defconfurs/dcfurs-badge-dc27/doc/mrswmy3pnzpwm5lsonpw65tbnr2gs3tf.png

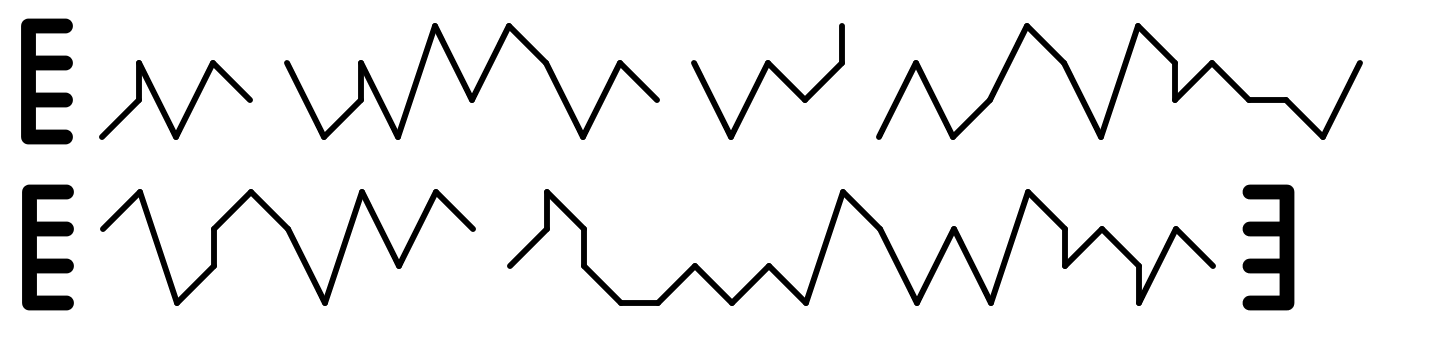
doc/mrswmy3pnzpwm5lsonpw65tbnr2gs3tf.png
