defconfurs/dcfurs-badge-dc27/doc/schematic.pdf

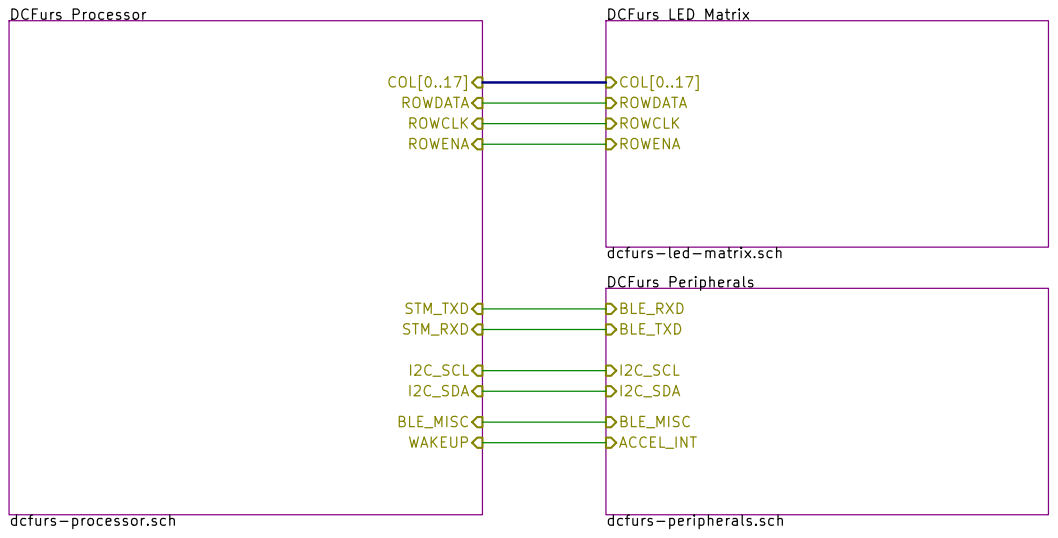
[picture p11: page 1]

ACCEL_INT DCFurs LED Matrix dcfurs-led-matrix.sch COL[0..17] ROWDATA ROWCLK ROWENA DCFurs Processor dcfurs-processor.sch

COL[0..17] ROWDATA ROWCLK ROWENA

File: dc27-fur-badge.sch Sheet: /
Id: 1/4 Title:

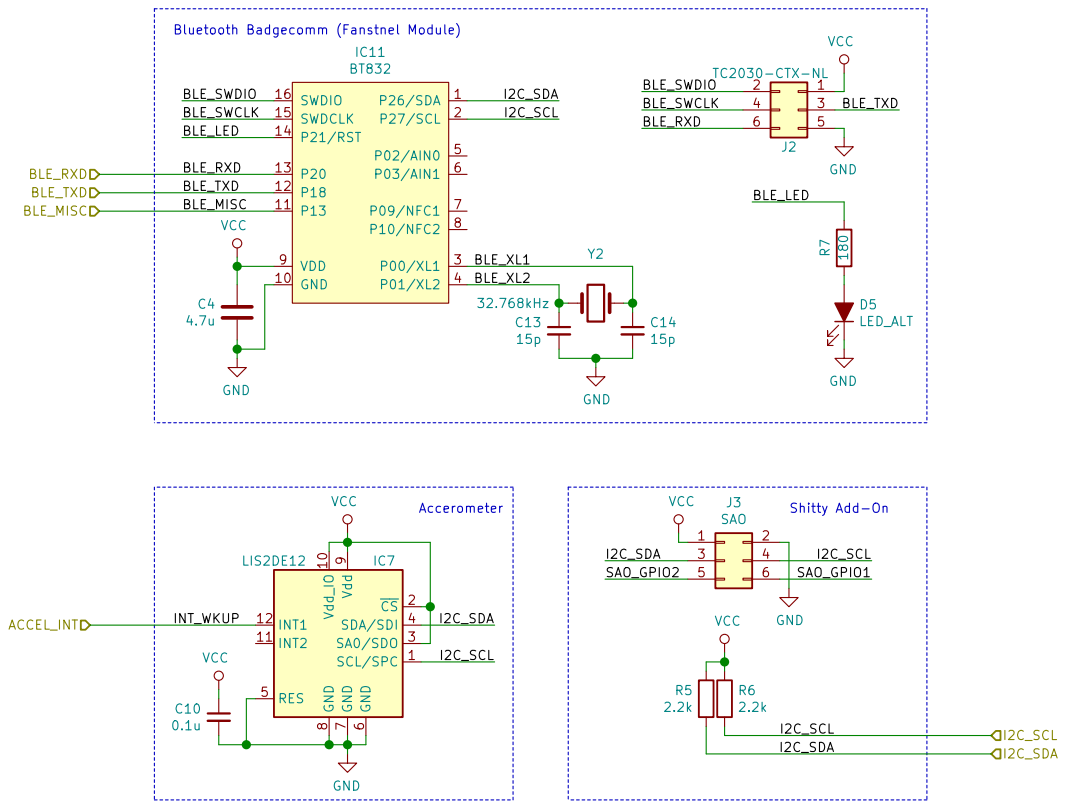
[picture p12: page 2]

Sheet: /DCFurs Peripherals/
File: dcfurs-peripherals.sch
Id: 2/4 Title:

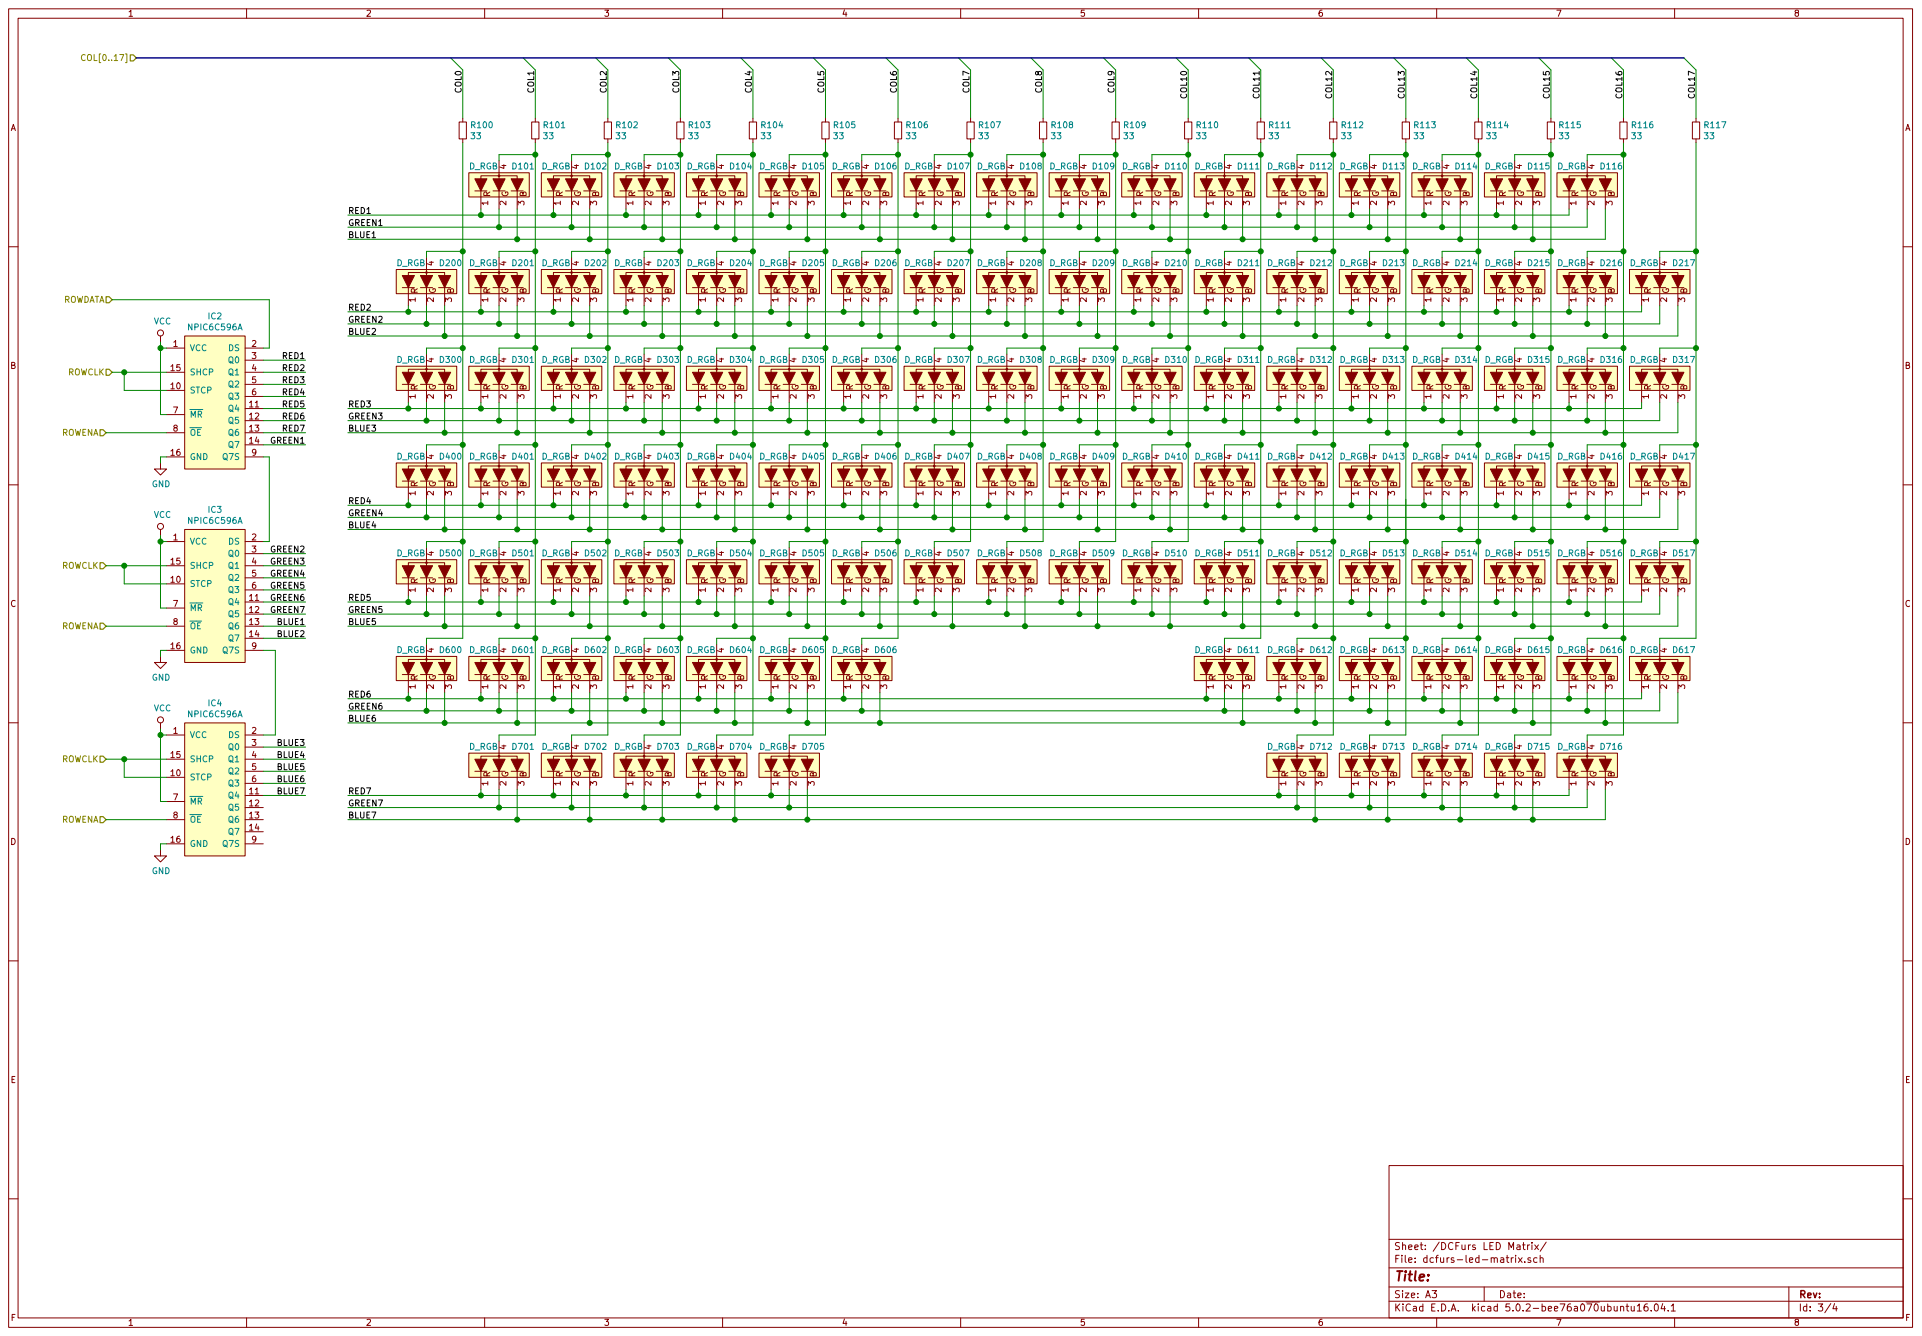
[picture p13: page 3]

Id: 3/4 Title: File: dcfurs-led-matrix.sch Sheet: /DCFurs LED Matrix/

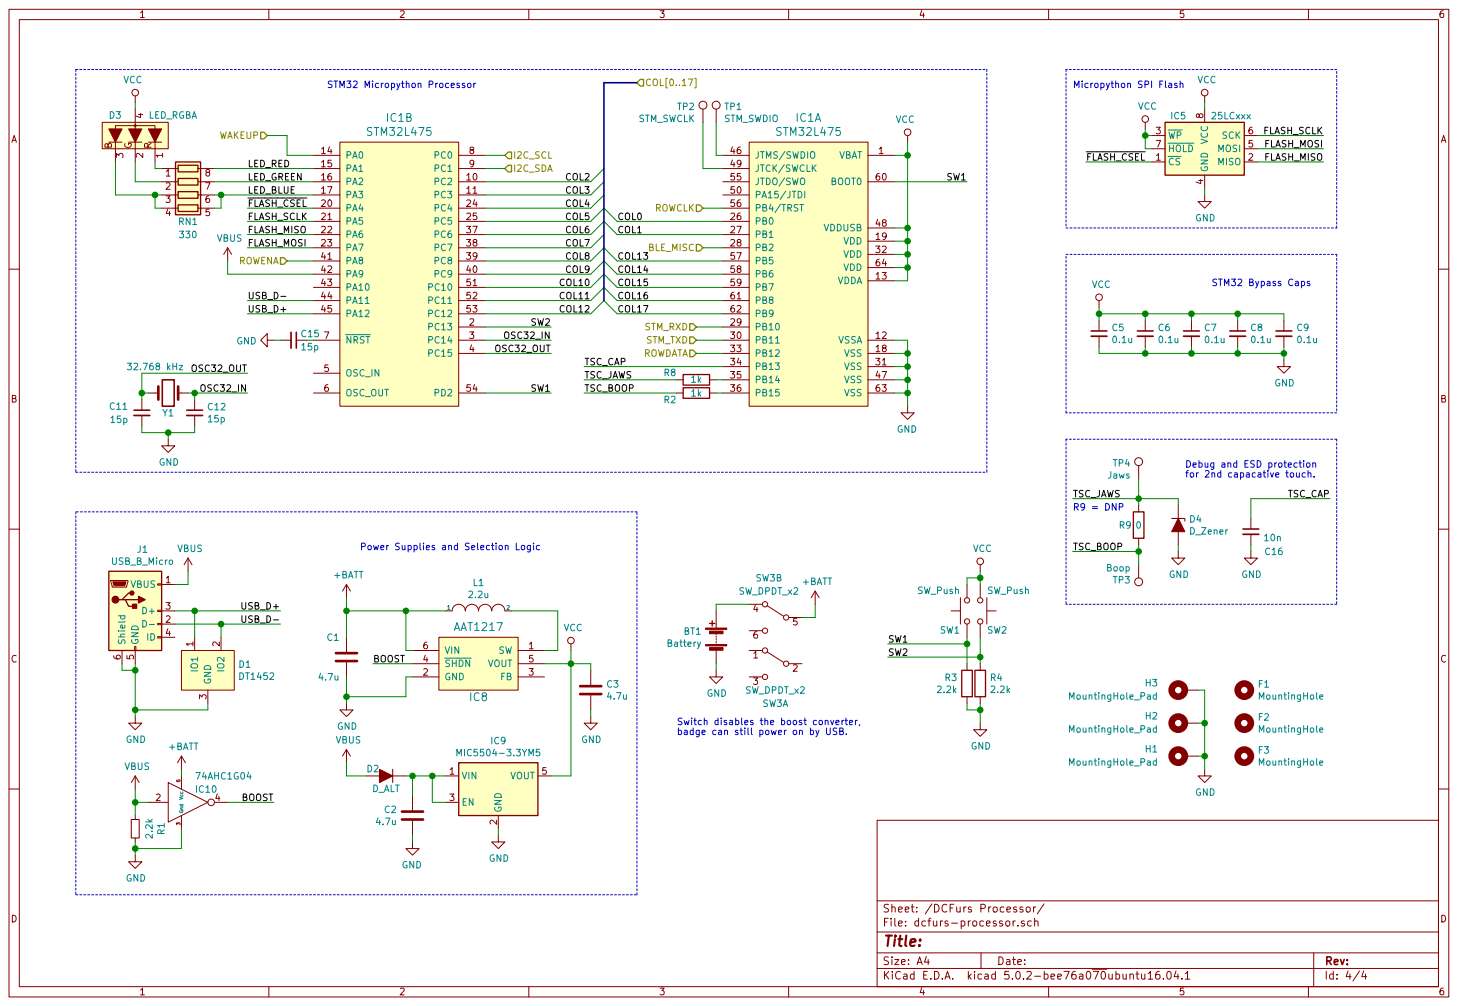
[picture p14: page 4]

4 MOSI 5 SCK 6 HOLD 7 VCC

Debug and ESD protection

File: dcfurs-processor.sch Sheet: /DCFurs Processor/
Id: 4/4 Title:
