defconfurs/dcfurs-badge-dc27/bluetooth.py

from pyb import I2C
import badge
import random

class bluetooth:
    I2C_ADDR = const(0x42)

    # Register Addresses
    REG_DEVID       = const(0x00)
    REG_SERIAL      = const(0x08)
    REG_STATE       = const(0x0a)
    REG_FLAGS       = const(0x0b)
    REG_COLOR       = const(0x0c)
    REG_DURATION    = const(0x0e)
    REG_RSSI        = const(0x10)
    REG_TTL         = const(0x11)
    REG_ORIGN       = const(0x12)
    REG_EMOTE       = const(0x14)

    # Writeable Addresses
    REG_ADVNAME     = const(0x1c)
    REG_COOLDOWN    = const(0x2c)
    REG_TXLEN       = const(0x2e)
    REG_TXMAGIC     = const(0x2f)
    REG_TXDATA      = const(0x30)

    # Supported Flags
    FLAG_EMOTE      = const(0x01)
    FLAG_COLOR      = const(0x02)
    FLAG_AWOO       = const(0x04)

    # Color Encoding
    COLOR_RANDOM    = const(0x7f)
    COLOR_WHITE     = const(0x7e)
    COLOR_HUE_MAX   = const(120)
    COLOR_HUE_STEPS = 3

    def __init__(self, bus, addr=I2C_ADDR):
        self.addr = addr
        self.bus = bus

    def read(self, reg):
        try:
            result = self.bus.mem_read(1, self.addr, reg)
            return result[0]
        except Exception:
            return 0
    
    def read16(self, reg):
        try:
            result = self.bus.mem_read(2, self.addr, reg)
            return result[0] + (result[1] << 8)
        except Exception:
            return 0
    
    def write(self, reg, value):
        try:
            self.bus.mem_write(bytearray([value]), self.addr, reg)
        except Exception:
            pass

    def write16(self, reg, value):
        try:
            buf = bytearray([(value & 0x00ff) >> 0, (value & 0xff00) >> 8])
            self.bus.mem_write(buf, self.addr, reg)
        except Exception:
            pass
    
    def transmit(self, magic, payload=None):
        buf = bytearray([0, magic])
        if payload:
            buf[0] = len(payload)
            buf += payload
        try:
            self.bus.mem_write(buf, self.addr, self.REG_TXLEN)
        except Exception:
            pass
    
    def flags(self):
        return self.read(self.REG_FLAGS)

    def color(self):
        reg = self.read(self.REG_COLOR)
        if (reg == self.COLOR_WHITE):
            return 0xffffff
        if (reg == self.COLOR_RANDOM):
            reg = random.randint(0, 120)
        return badge.hue2rgb(reg * self.COLOR_HUE_STEPS)
    
    def hue(self):
        reg = self.read(self.REG_COLOR)
        if (reg == self.COLOR_WHITE):
            return None
        if (reg == self.COLOR_RANDOM):
            return random.randint(0, 360)
        return reg
