defconfurs/dcfurs-badge-dc27/(commit log)

2019-06-24 Import animations and board support from DC26.
2019-06-28 Fix signed math in LIS2DE12 accelerometer.
    Some shoddy math meant that accelerometer readings were always positive
    which bugged out a couple animations. While we're at it we also need
    to negate the X and Y axis to match the badge orientation from the DC26
    badge.
    [lis2de12.py]
2019-07-07 Add fallback to a dummy accelerometer.
    Some of the prototype badges had rework isses on their accelerometer, so
    if the badge fails to detect it on the I2C bus, create a dummy class in
    its place to keep the firmware running happy.
    [badge.py, lis2de12.py]
2019-07-15 Add parsing of color data from JSON.
    The JSON animation format now accepts two new encodings for color data:
    rgb8 and palette.
    The first format is identified by a dict key of 'rgb8' containing the
    frame data with each pixel given by a pair of hexadecimal characters,
    and rows delimited by colons. The colorspace used in this format gives
    3-bits of red, 3-bits of green and 2-bits of blue.
    The second format is identified by a dict key of 'palette' containing
    the frame data, with each pixel given by a single exadecimal nibble,
    and rows delimited by colons. This format uses a palette consisting of
    the 16 xterm system colors (0-15).
    8-Bit RGB: https://en.wikipedia.org/wiki/8-bit_color
    Xterm Colo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
2019-07-16 Copy and update the README from DC26.
    Pretty much the same as last year with a couple of technical updates
    due to the hardware changes, and some new APIs for the color support.
2019-07-16 Increase PWM frequency to 500kHz.
    The PWM frequency needs a bit of a boost to cope with the increased
    bit depth added by the RGB565 support in the micropython firmware.
2019-07-28 Add badge schematic.
2019-08-01 DranoTheCat's 2019 Animations Initial Commit
    These probably still have bugs that DranoTheCat is working out.
    [hyperspace.py, rainbowLights.py]
2019-08-03 Added sparkle animation and fixed (hopefully) crash on certain json loads
    [sparkle.py]
2019-08-05 Use double switch press to toggle cap sense channel.
    Pressing both switches at the same time allows the user to switch
    capacative touch between the nose and the teeth area of the badge
    which helps keep the capacative touch sensitivity aligned with the
    nose of the acrylic face.
2019-08-06 Fix exception in bluetooth setup.
    [badge.py]
2019-08-06 Increate I2C baudrate to 400kHz
2019-08-06 Workaround for bluetooth module crash
    A rare crash of the bluetooth module has been seen, that can trigger
    the watchdog. When this occurs the badge can crash due to the I2C
    access timing out during the reboot. A few try/except blocks should
    handle it gracefully.
    [bluetooth.py]
2019-08-09 Update firmware to use hardware SPI for filesystem.
2019-08-13 Add assembly guide and mechanical details.
    [stencil-paste-bottom.gbp, stencil-paste-top.gtp]
2019-08-14 Added fire effect. (#2)
    * Added fire effect.
    * Fix row/column references in the API documentation.
    * Added some comments and docstrings.
    * Integrated Boop text into the flames.
    * Sort the list of animations, so cycling through them is always consistent.
    * Fixed boop mask iteration.
    * Removed unit test. Shade the background when displaying Boop.
    [fire.py, main.py]
